vpzed/keyboards/README.md

# Keyboards

Custom keyboards designed for fun.

- Toast - A blocky 34 key split ergo keyboard roughly based on the [A.dux](https://github.com/tapioki/cephalopoda/tree/main/Architeuthis%20dux) by tapioki.
