vpzed/keyboards/toast/v1/README.md

# Toast v1

Config uses ergogen 3.1 fork at
https://github.com/MvEerd/ergogen
for the extra footprints

- PCB added
- Gerbers added
- Boards ordered from posted gerbers
- First keyboard build completed with no issues
- QMK a_dux firmware works with no changes
