vpzed/keyboards/toast/media/toast1-pcb-3d.png

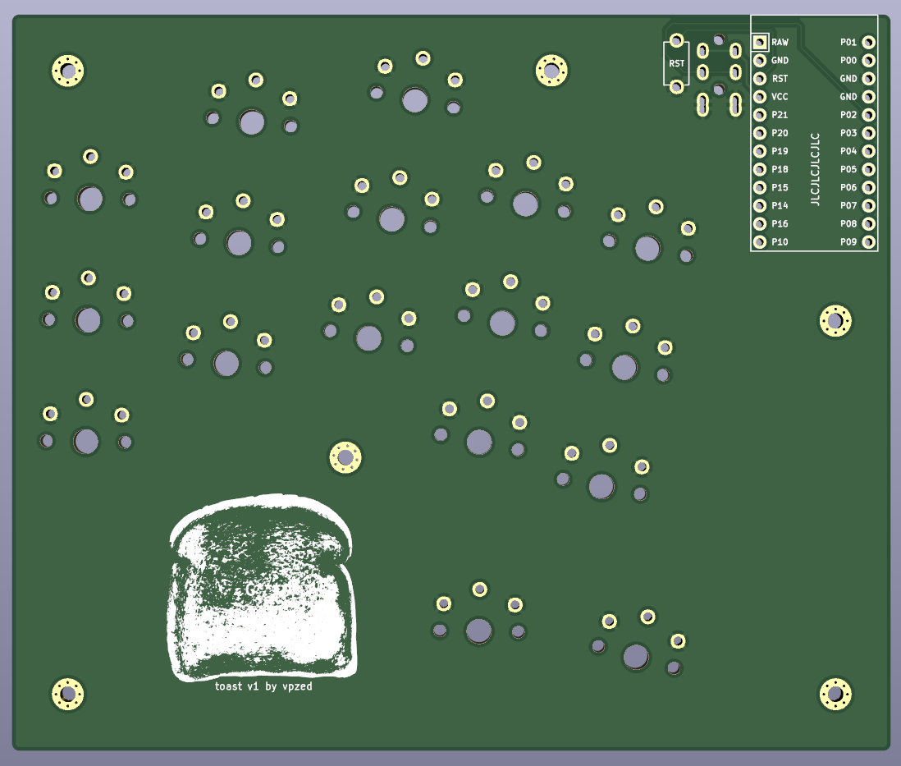
toast/media/toast1-pcb-3d.png
