vpzed/keyboards/toast/media/toast-proto1.png

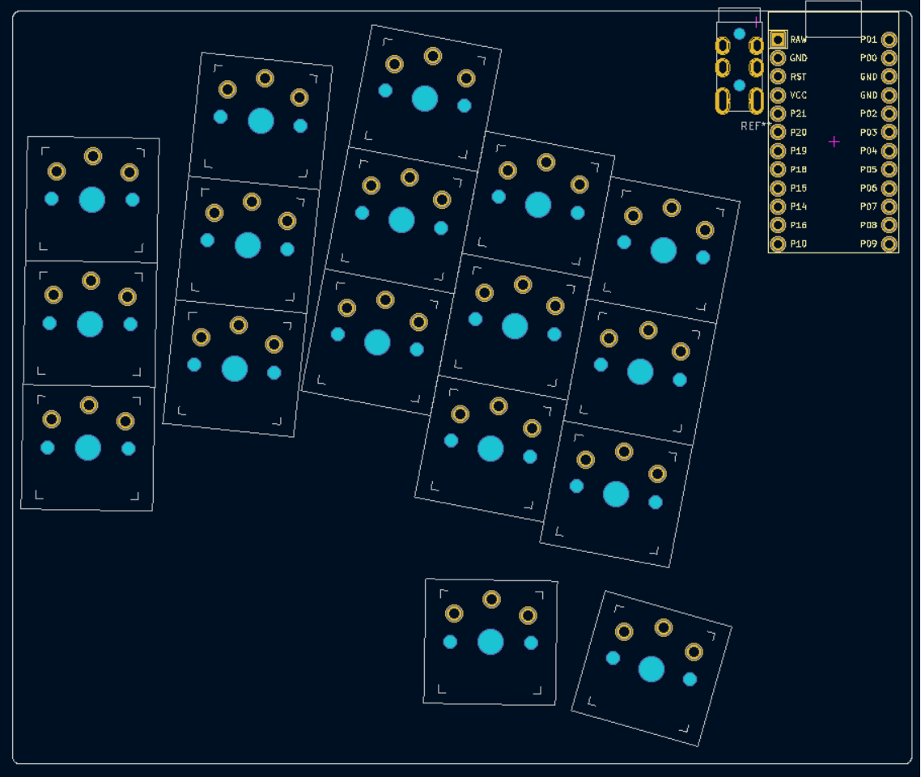
toast/media/toast-proto1.png
