vpzed/keyboards/toast/v1/toast-v1.kicad_pcb

## KiCad design toast/v1/toast-v1.kicad_pcb (2022-04-08)

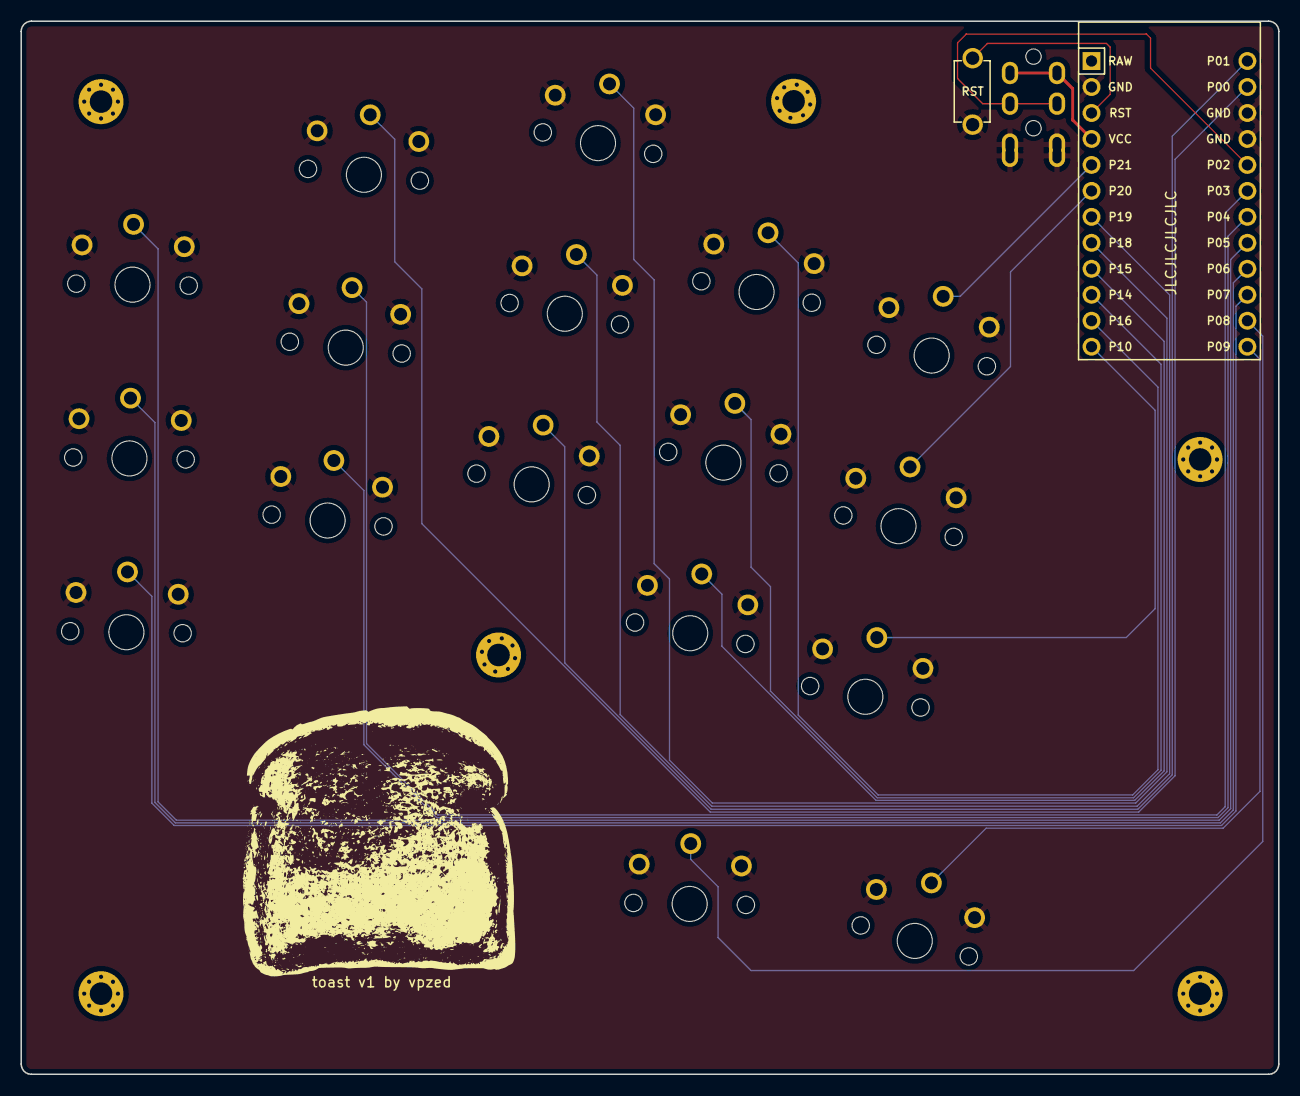
[picture p6: board toast-v1.kicad_pcb from above]

Board: 2 copper layers, 123.0 x 103.0 mm, 25 parts (0 on the bottom side), 19 nets.

Parts:
B1: SW_RST; TACT_SWITCH_TVBP06
HOLE1, HOLE2, HOLE3, HOLE4, HOLE5, HOLE6: MountingHole_2.2mm_M2_Pad_Via
MCU1: ProMicro
S1, S2, S3, S4, S5, S6, S7, S8, S9, S10, S11, S12, S13, S14, S15, S16, S17: PG1350

Connections:
GND: B1.1, MCU1.2, MCU1.15, MCU1.16, S1.1, S2.1, S3.1, S4.1, S5.1, S6.1, S7.1, S8.1, S9.1, S10.1, S11.1, S12.1, S13.1, S14.1, S15.1, S16.1, S17.1
RST: B1.2, MCU1.3
fingers_index_bottom: MCU1.9, S10.2
fingers_index_home: MCU1.10, S11.2
fingers_index_top: MCU1.11, S12.2
fingers_inner_bottom: MCU1.12, S13.2
fingers_inner_home: MCU1.6, S14.2
fingers_inner_top: MCU1.5, S15.2
fingers_middle_bottom: MCU1.13, S7.2
fingers_middle_home: MCU1.7, S8.2
fingers_middle_top: MCU1.8, S9.2
fingers_pinky_bottom: MCU1.22, S1.2
fingers_pinky_home: MCU1.21, S2.2
fingers_pinky_top: MCU1.20, S3.2
fingers_ring_bottom: MCU1.19, S4.2
fingers_ring_home: MCU1.18, S5.2
fingers_ring_top: MCU1.14, S6.2
thumb_home: MCU1.24, S17.2
thumb_tucky: MCU1.23, S16.2
