vpzed/keyboards/(commit log)

2022-04-04 add toast prototype image
2022-04-06 added mounting holes and reset switch option
2022-04-06 corrected pcb name
2022-04-07 add pcb and update readme
    [toast-v1.kicad_pcb]
2022-04-08 finals for order
    [toast-v1-B_Cu.gbl, toast-v1-B_Mask.gbs, toast-v1-B_Paste.gbp, toast-v1-B_Silkscreen.gbo, toast-v1-Edge_Cuts.gm1, toast-v1-F_Cu.gtl, toast-v1-F_Mask.gts, toast-v1-F_Paste.gtp]
2022-04-30 Update Readme with first board completed info
2022-04-30 Added link to gerbers.zip
